jx2014/Attiny_Parallel_HV_Programming/at2313a_parallel_programmer.pdf

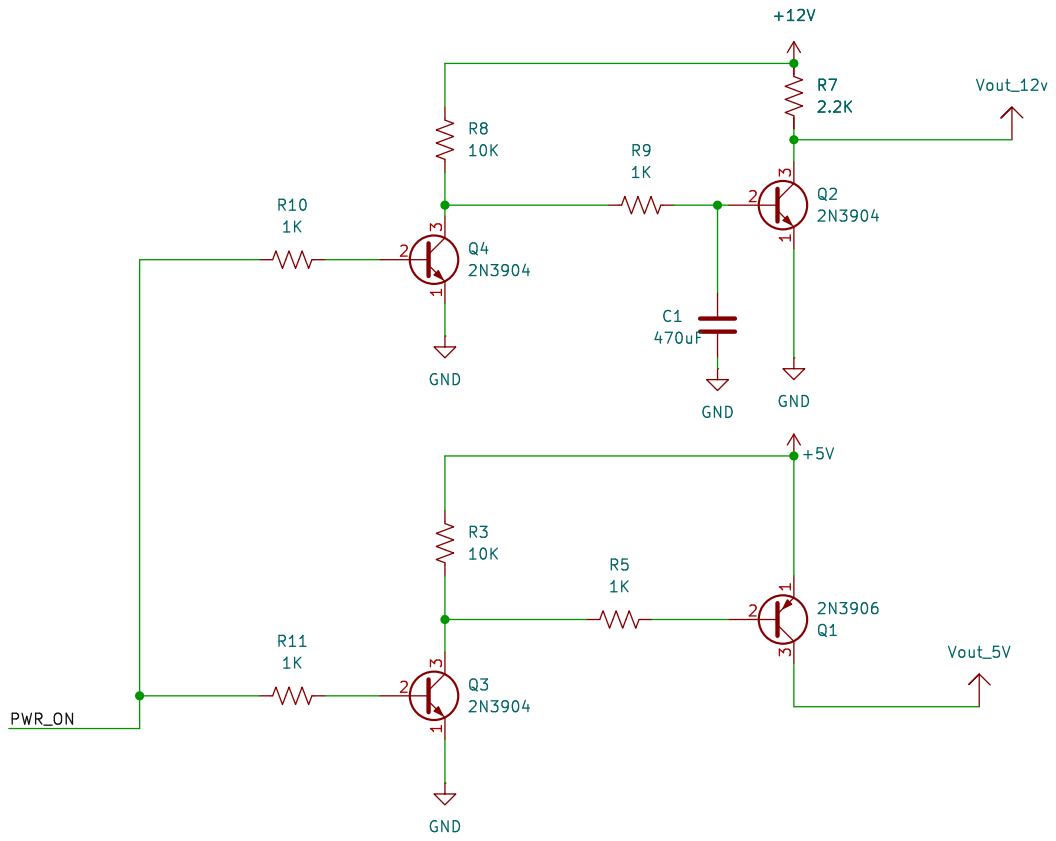
[picture p5: page 1]

Id: 1/2 Title: File: at2313a_parallel_programmer.kicad_sch Sheet: /

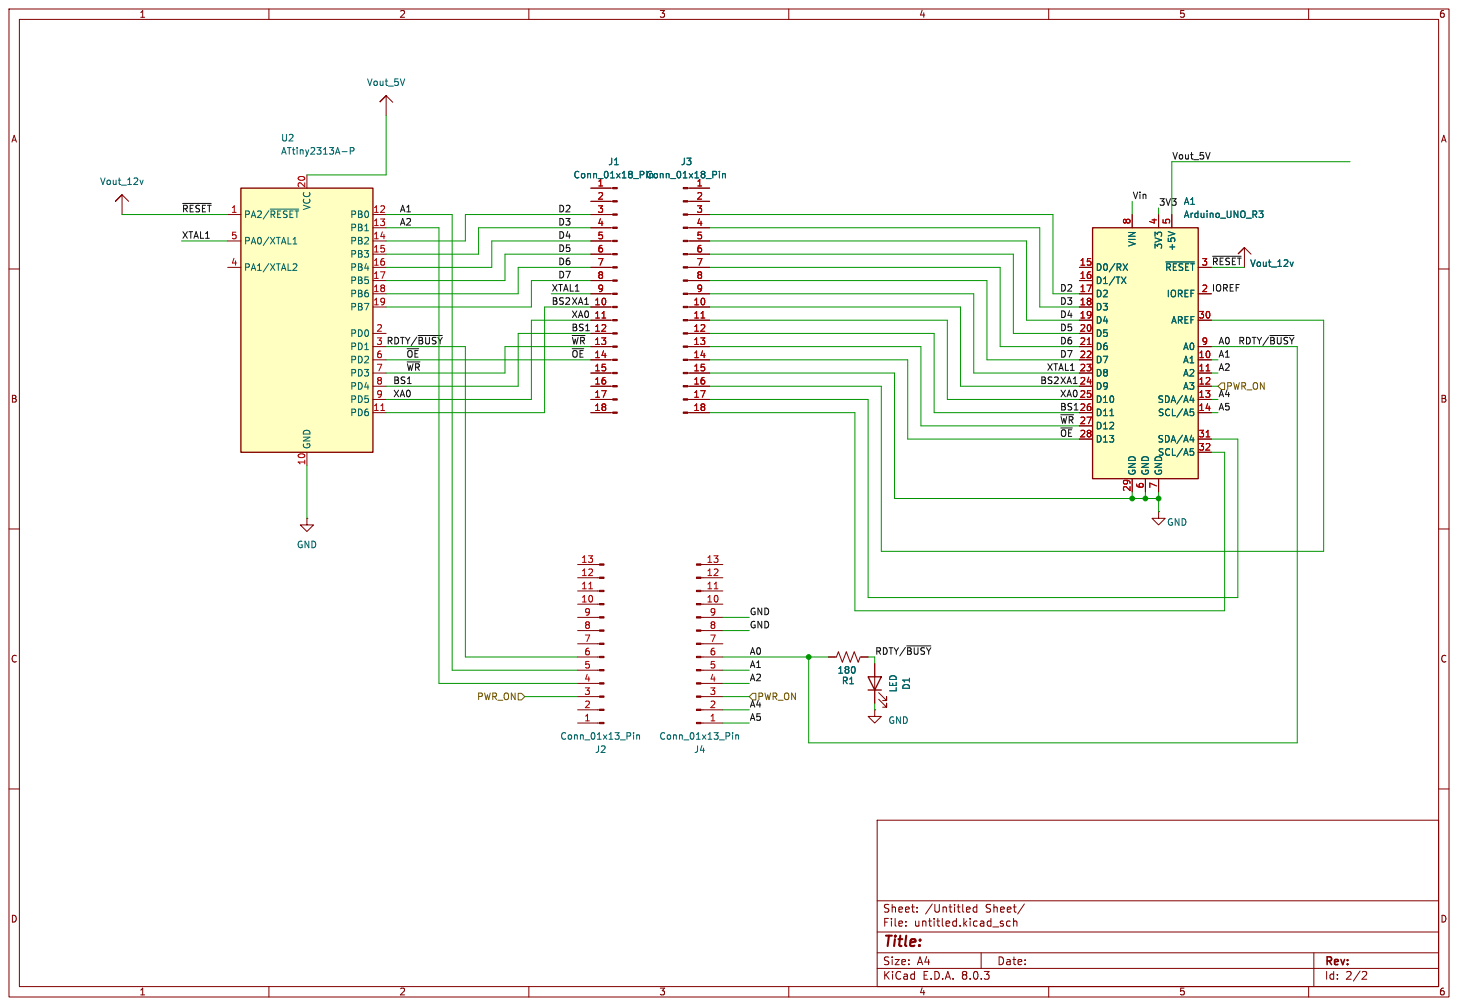
[picture p6: page 2]
