jx2014/Attiny_Parallel_HV_Programming/images/1.jpg

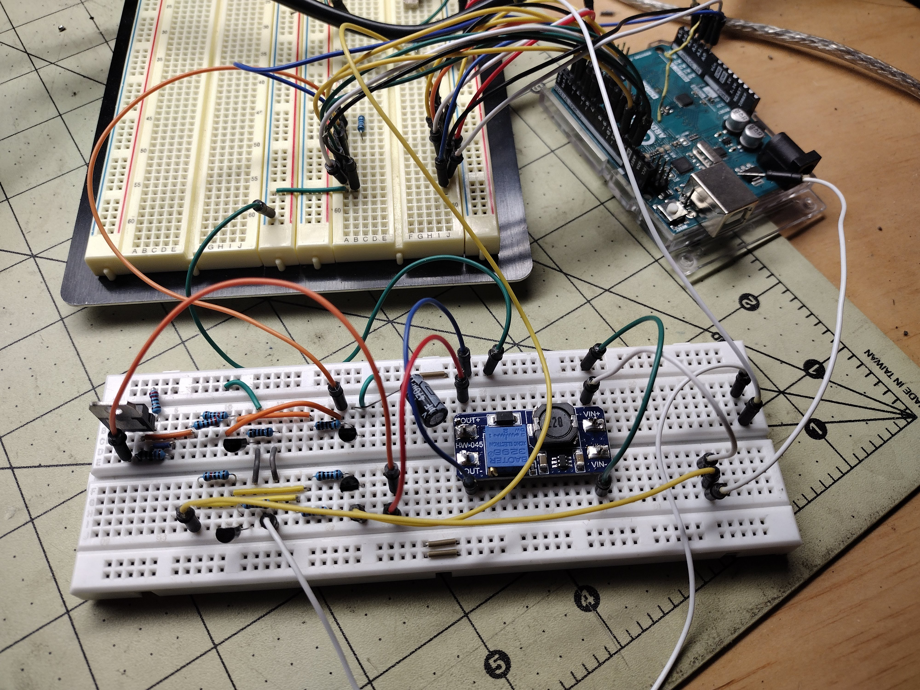
[picture p1: images/1.jpg]
images/1.jpg
